hydronics2/nrf52840-PCC-January-2020/soldering/eagle_design_files/README.md

# Printed Circuit Board

This circuit board was designed in Eagle. Order the board on [Oshpark](https://oshpark.com/shared_projects/VXKHXb9R).

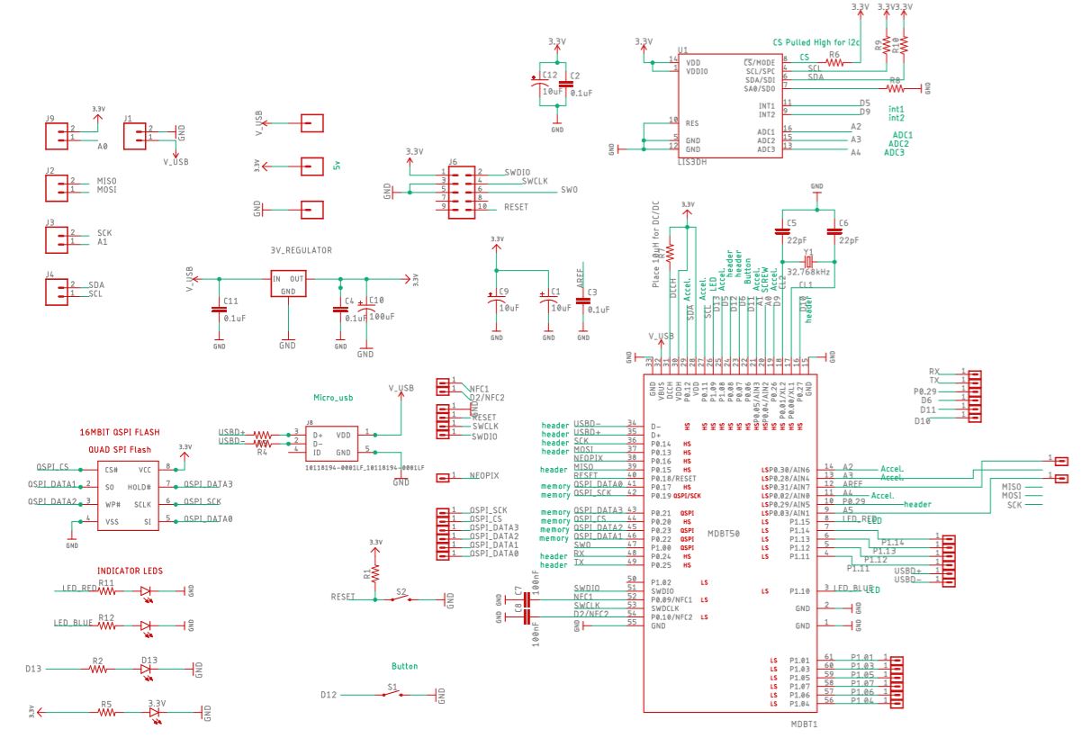
[picture p15: soldering/pics/schematic1.JPG]


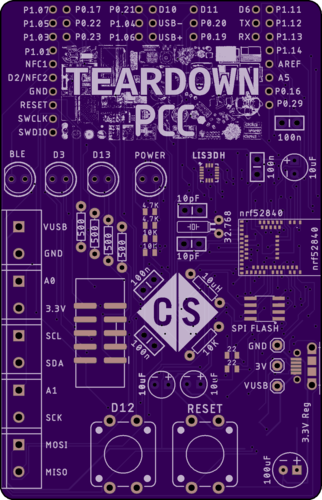
[picture p16: soldering/eagle_design_files/blank_top.png]


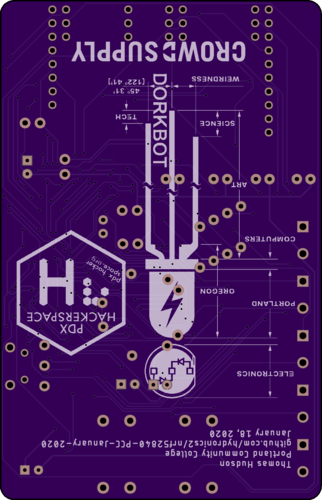
[picture p17: soldering/eagle_design_files/blank_bottom.png]
