hydronics2/nrf52840-PCC-January-2020/handout.pdf

## Teardown 2019 - Soldering and Web BLE tutorial

This is a soldering and programming class in Circuitpython that includes a Web Ble demo

github.com/hydronics2/Teardown-2019

This class occurs in two parts -- Soldering and Programming.

We'll be soldering parts and headers onto a custom printed circuit board(PCB).
This board is a copy of the Adafruit Feather nrf52840 express.

When you connect from USB to your computer it shows up as an external hard drive with pre-loaded example scripts.

Soldering Tutorial

Programming Tutorial

## Soldering

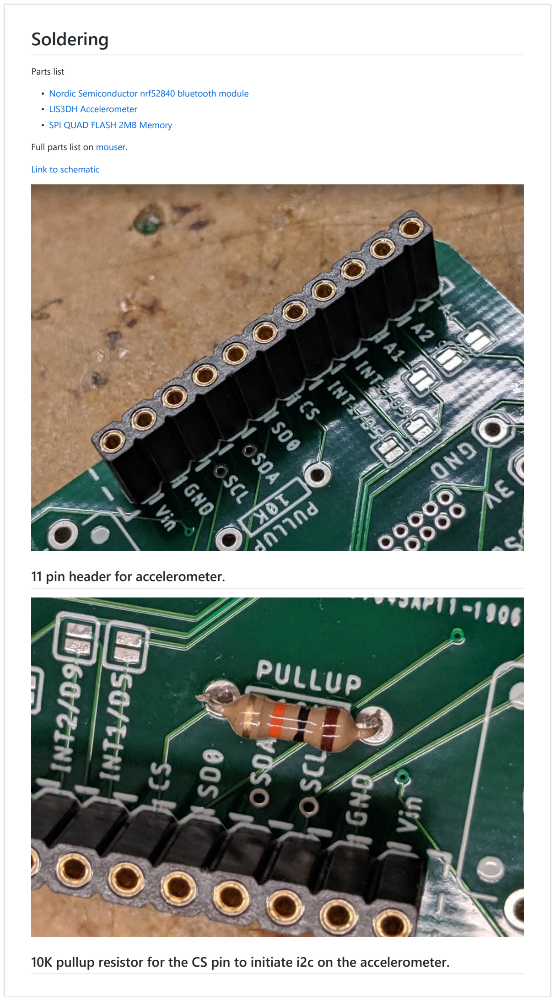
[picture p19: page 2]

Parts list

- Nordic Semiconductor nrf52840 bluetooth module
- LIS3DH Accelerometer
- SPI QUAD FLASH 2MB Memory

Full parts list on mouser.

Link to schematic

11 pin header for accelerometer.

10K pullup resistor for the CS pin to initiate i2c on the accelerometer.

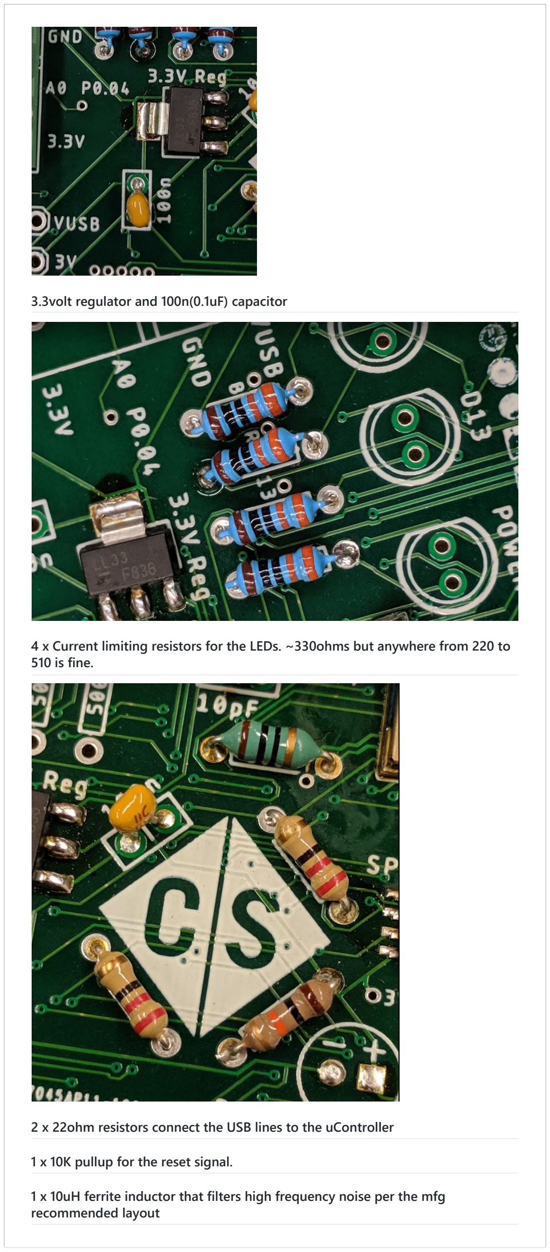
[picture p20: figure]
3.3volt regulator and 100n(0.1uF) capacitor; 510 is fine.; 1 x 10K pullup for the reset signal.; recommended layout

### 4 x Current limiting resistors for the LEDs. ~330ohms but anywhere from 220 to

### 2 x 22ohm resistors connect the USB lines to the uController

### 1 x 10uH ferrite inductor that filters high frequency noise per the mfg

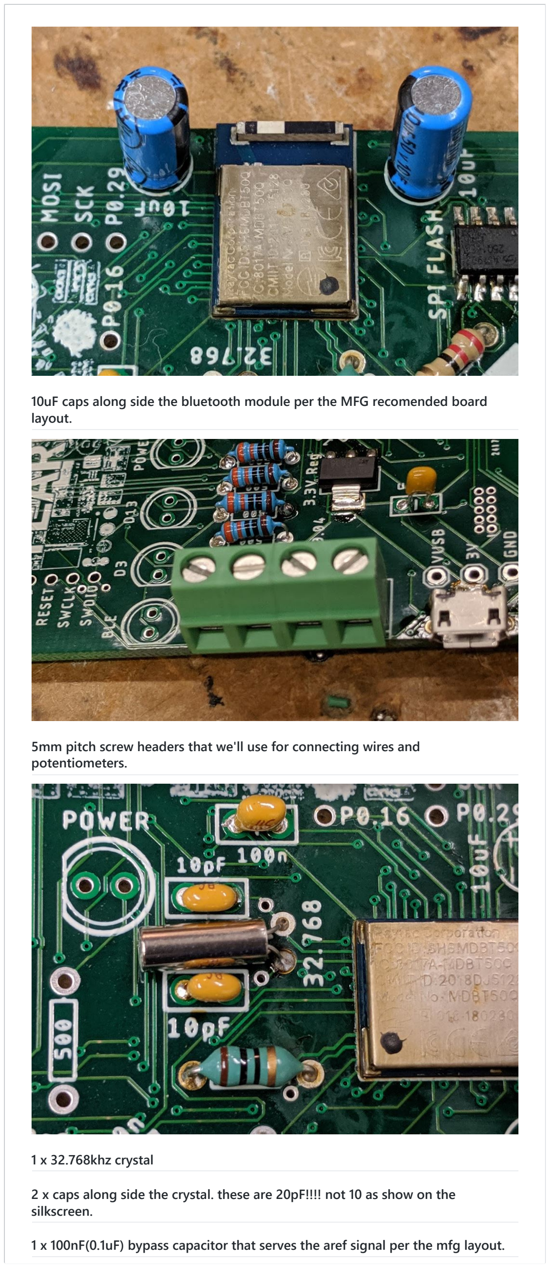
[picture p21: figure]
layout.; potentiometers.; 1 x 32.768khz crystal; silkscreen.

10uF caps along side the bluetooth module per the MFG recomended board

5mm pitch screw headers that we'll use for connecting wires and

### 2 x caps along side the crystal. these are 20pF!!!! not 10 as show on the

1 x 100nF(0.1uF) bypass capacitor that serves the aref signal per the mfg layout.

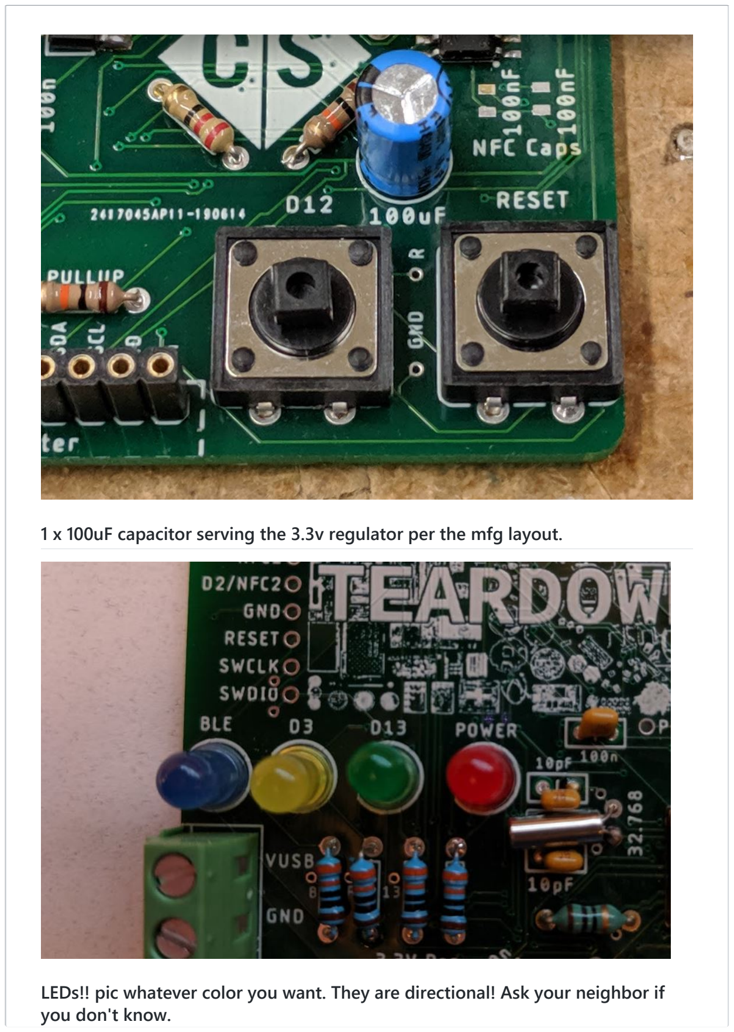
[picture p22: page 5]

1 x 100uF capacitor serving the 3.3v regulator per the mfg layout.

## LEDs!! pic whatever color you want. They are directional! Ask your neighbor if

you don't know.

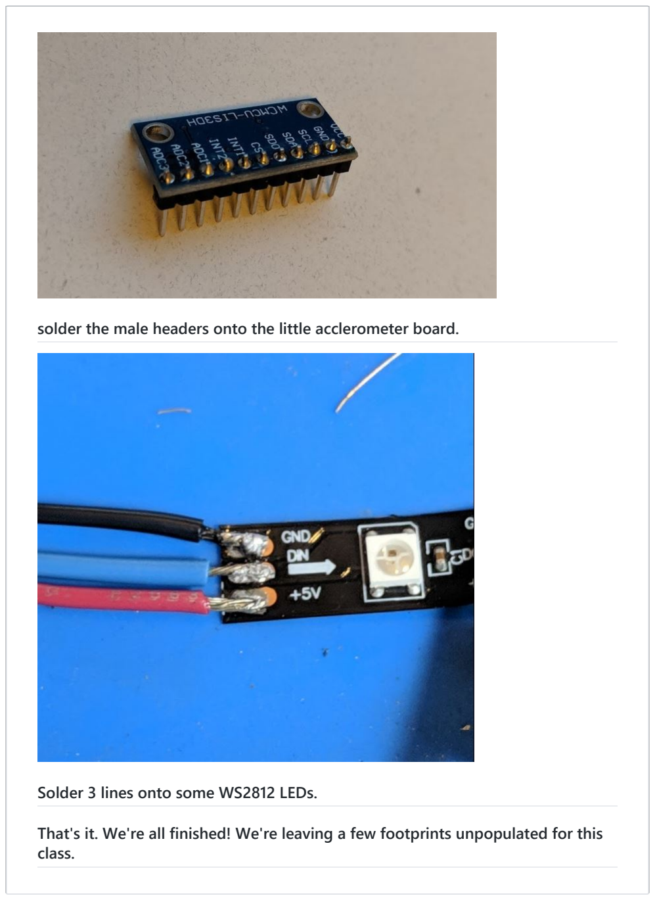
[picture p23: page 6]

solder the male headers onto the little acclerometer board.

Solder 3 lines onto some WS2812 LEDs.

## That's it. We're all finished! We're leaving a few footprints unpopulated for this

class.

# CircuitPython

If you need to flash a bare board... here are some steps..

I uploaded the python scripts onto the 2MB SPI Flash chip before the class. When you plug the unit into your board it appears as a flash drive.

Download and install the MU editor if you have not done so already.

## code.py

LOAD the code.py script. Code.py determines which scripts run. Uncomment the files you would like to run.

## blink

LOAD the "blink.py" script that's currently running. It blinks the LEDs on pin 13, pin 3, and BLUE_LED pin. Try adjusting the time.sleep(x) to speed up the blinking.

## Web Ble

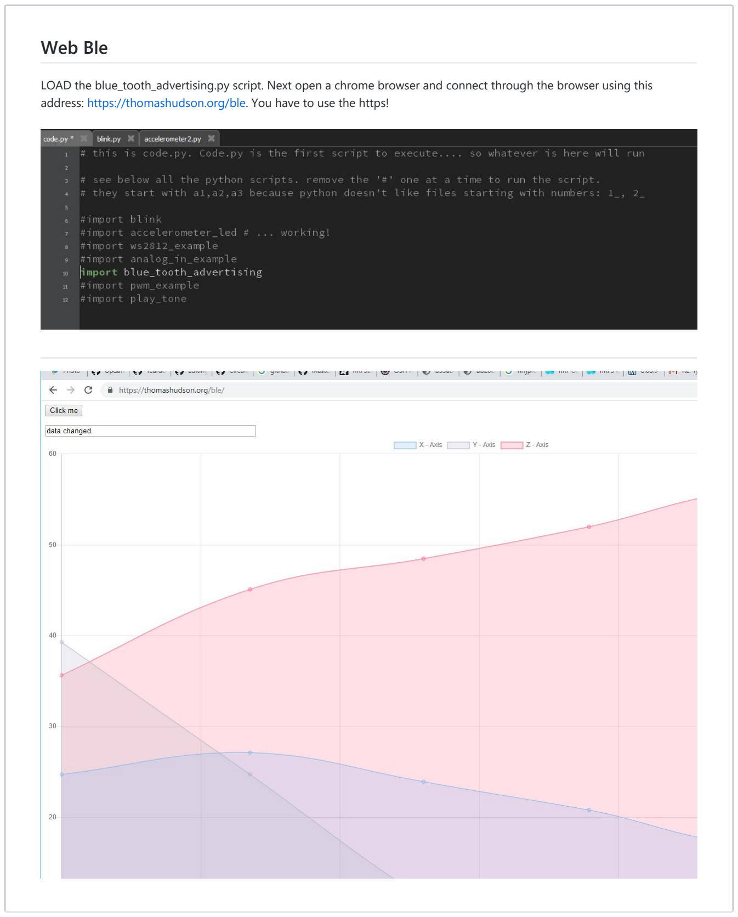
[picture p24: page 8]

LOAD the blue_tooth_advertising.py script. Next open a chrome browser and connect through the browser using this address: https://thomashudson.org/ble. You have to use the https!

## accelerometer

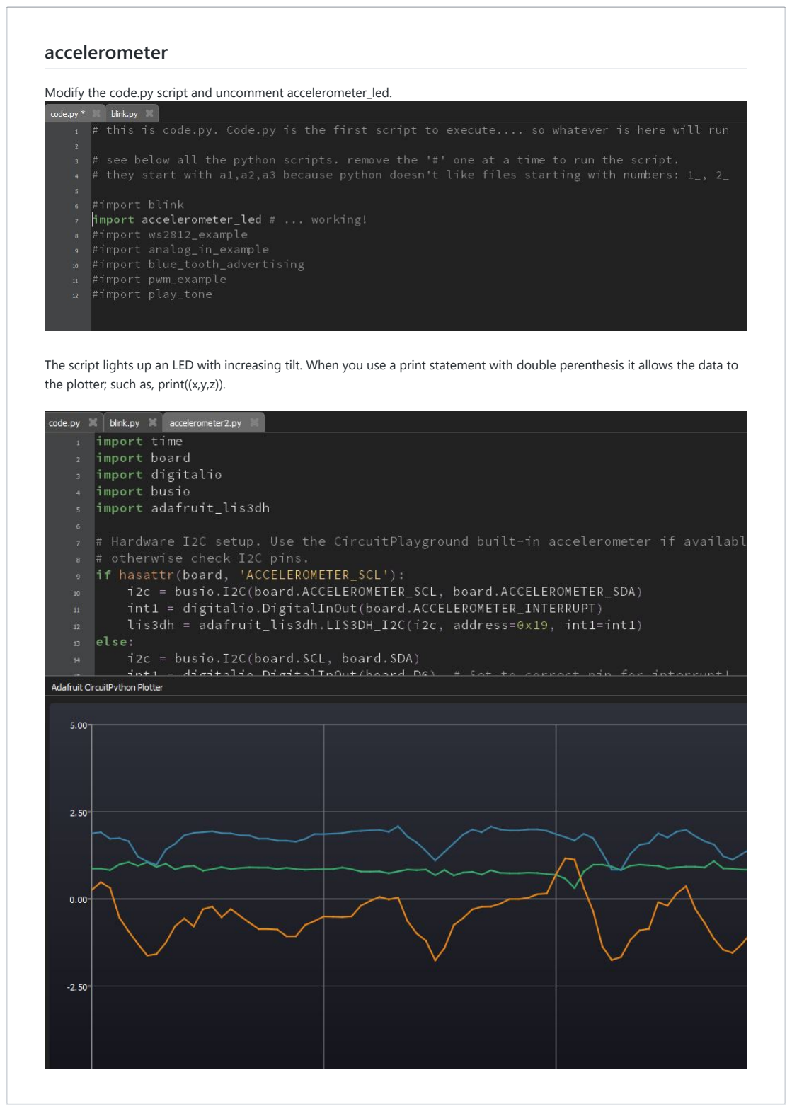
[picture p25: page 9]

Modify the code.py script and uncomment accelerometer_led.

The script lights up an LED with increasing tilt. When you use a print statement with double perenthesis it allows the data to the plotter; such as, print((x,y,z)).

## ws2812_example

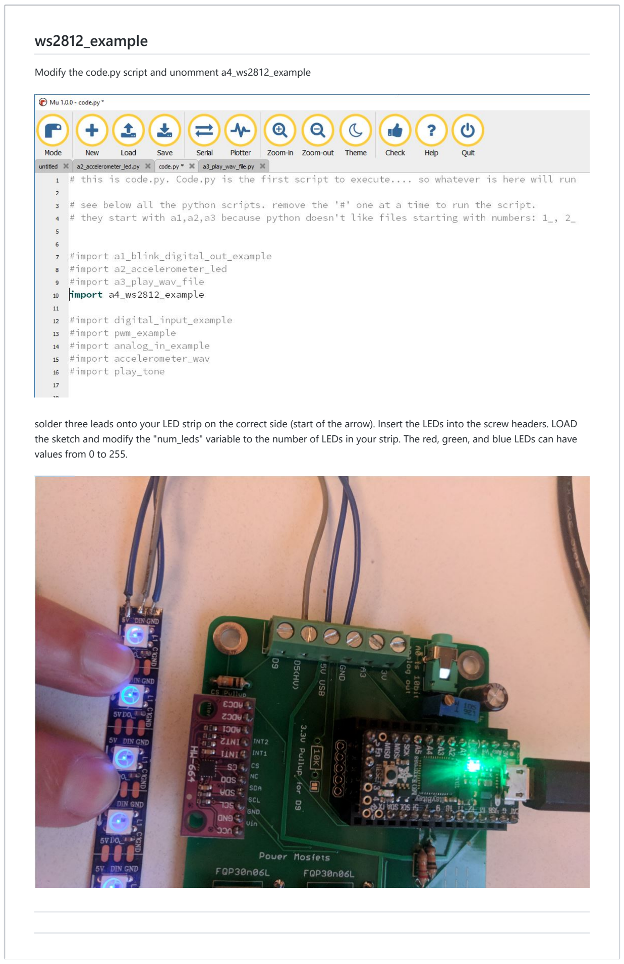
[picture p26: page 10]

Modify the code.py script and unomment a4_ws2812_example

solder three leads onto your LED strip on the correct side (start of the arrow). Insert the LEDs into the screw headers. LOAD the sketch and modify the "num_leds" variable to the number of LEDs in your strip. The red, green, and blue LEDs can have values from 0 to 255.

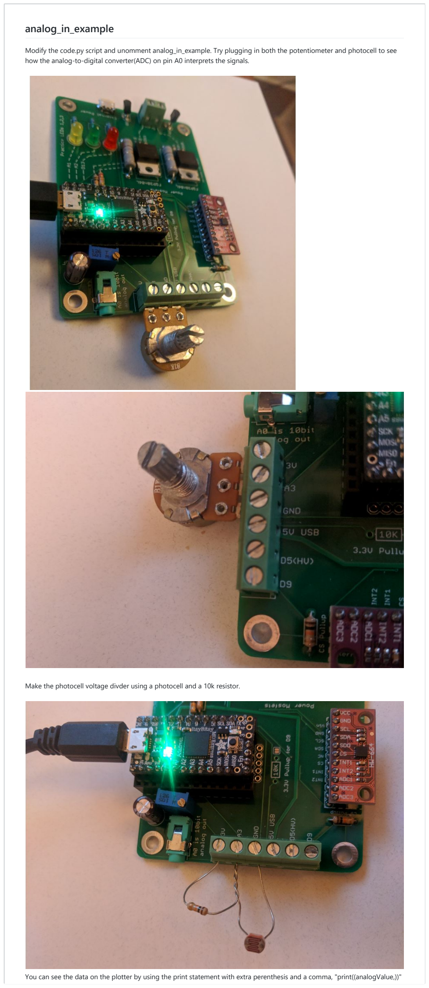
[picture p27: page 11]

analog_in_example

Modify the code.py script and unomment analog_in_example. Try plugging in both the potentiometer and photocell to see how the analog-to-digital converter(ADC) on pin A0 interprets the signals.

Make the photocell voltage divder using a photocell and a 10k resistor.

You can see the data on the plotter by using the print statement with extra perenthesis and a comma, "print((analogValue,))"
