hydronics2/nrf52840-PCC-January-2020/soldering/eagle_design_files/blank_top.JPG

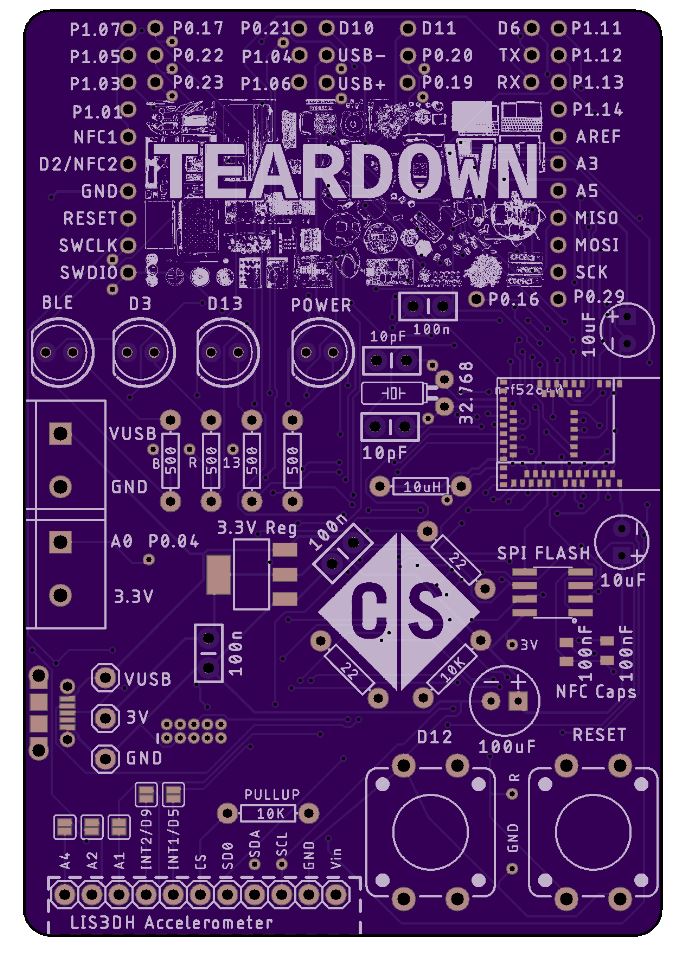
soldering/eagle_design_files/blank_top.JPG
