hydronics2/nrf52840-PCC-January-2020/soldering/README.md

# Soldering Instructions

## https://github.com/hydronics2/nrf52840-PCC-January-2020
Parts list
- [Nordic Semiconductor nrf52840 bluetooth module](https://www.adafruit.com/product/4078)
- [SPI QUAD FLASH 2MB Memory](https://www.digikey.com/product-detail/en/gigadevice-semiconductor-hk-limited/GD25Q16CTIGR/1970-1010-1-ND/9484760)

Full parts list on [mouser](https://www.mouser.com/ProjectManager/ProjectDetail.aspx?AccessID=5d5a690db9).

[Link to schematic](https://github.com/hydronics2/nrf52840-PCC-January-2020/blob/master/soldering/eagle_design_files/PCB_schematic1.pdf)

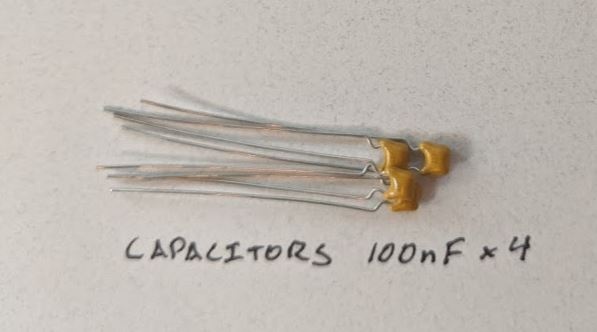
[picture p30: soldering/pics/1caps.jpg]

## qty(4) 100nF capacitors. not polarity specific.

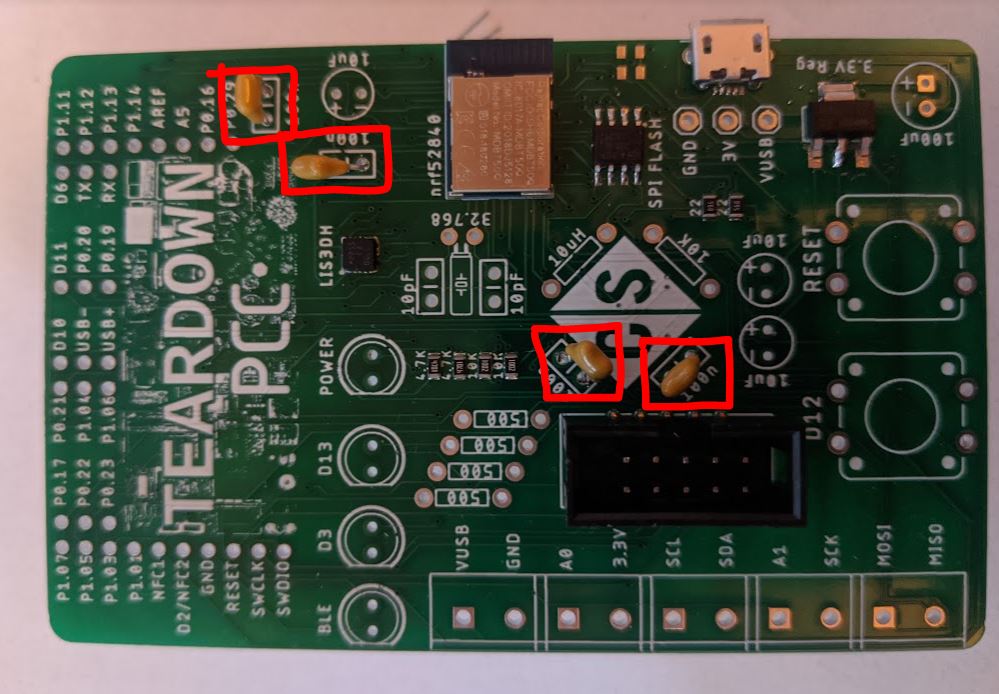
[picture p31: soldering/pics/2caps.JPG]


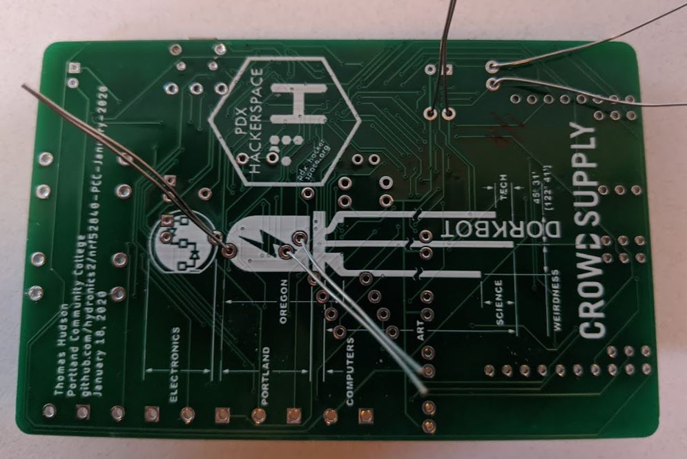
[picture p32: soldering/pics/3caps.JPG]


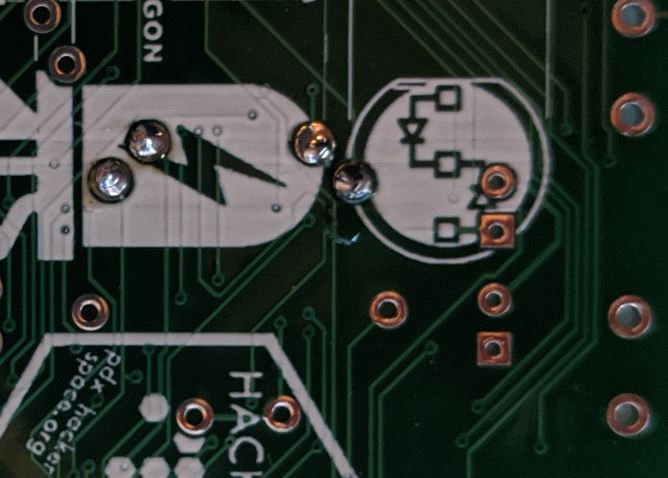
[picture p33: soldering/pics/4caps.JPG]

## push through the PCB, solder, and trim leads
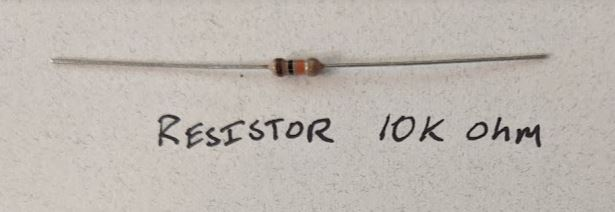
[picture p34: soldering/pics/5resistor.JPG]

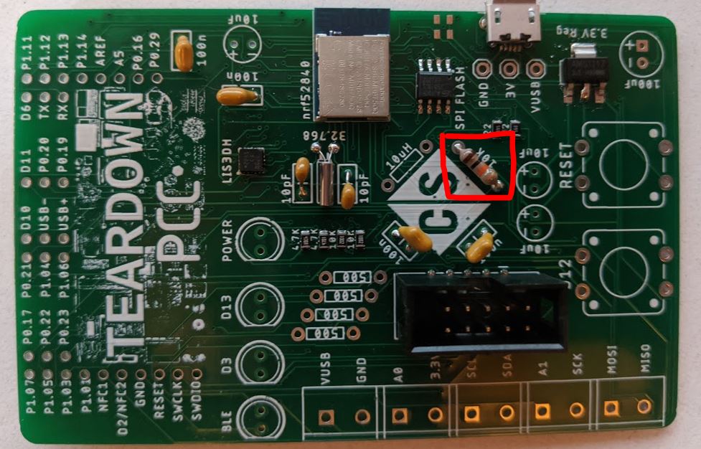
[picture p35: soldering/pics/6resistor.JPG]

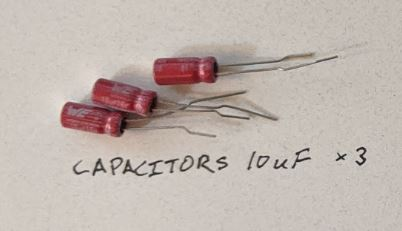
[picture p36: soldering/pics/7caps.JPG]

## qty(3) capacitors 10uF. POLARITY!!! match the stripe to the negative symbol (-)
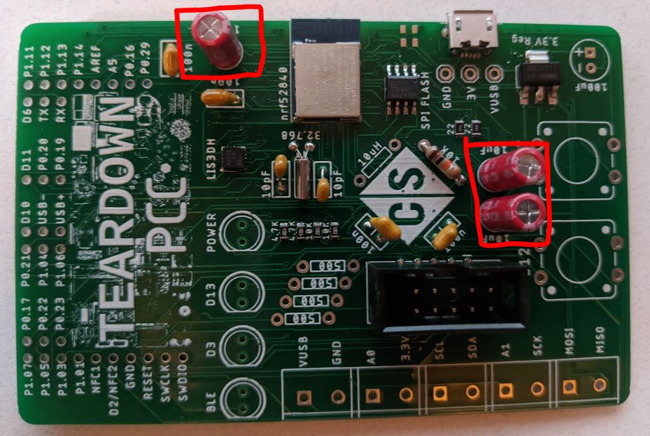
[picture p37: soldering/pics/8caps.JPG]

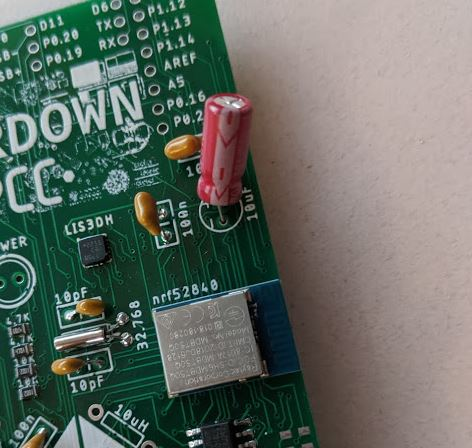
[picture p38: soldering/pics/9caps.JPG]

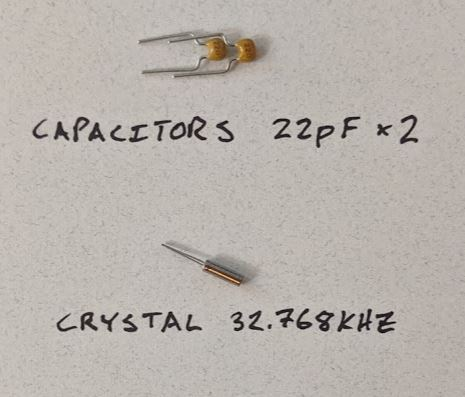
[picture p39: soldering/pics/10caps_crystal.JPG]

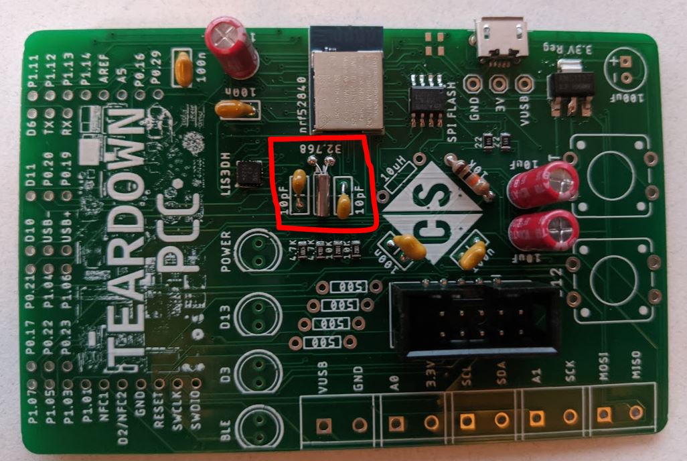
[picture p40: soldering/pics/11caps_crystal.JPG]

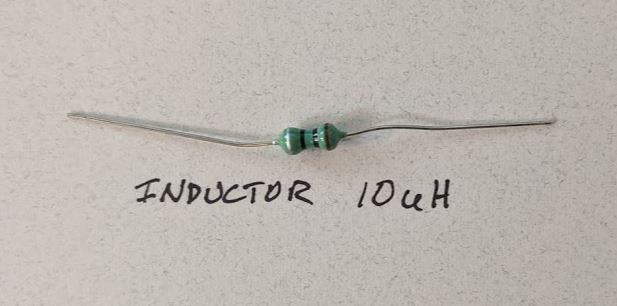
[picture p41: soldering/pics/12inductor.JPG]

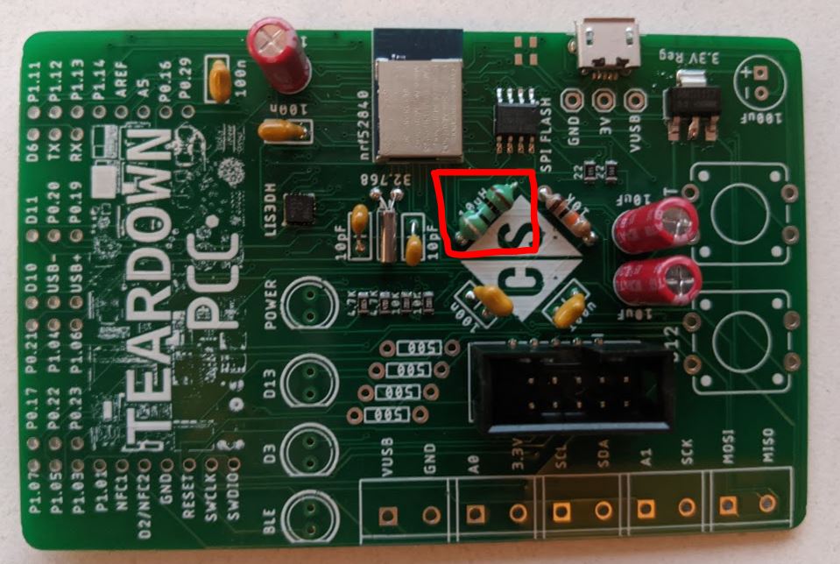
[picture p42: soldering/pics/13inductor.JPG]

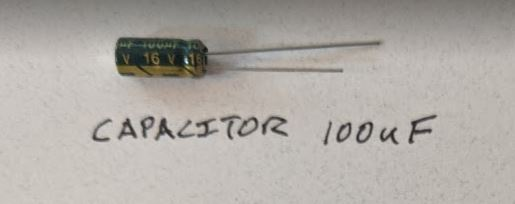
[picture p43: soldering/pics/14caps.JPG]

## qty(1) capacitors 100uF. POLARITY!!! match the stripe to the negative symbol (-)
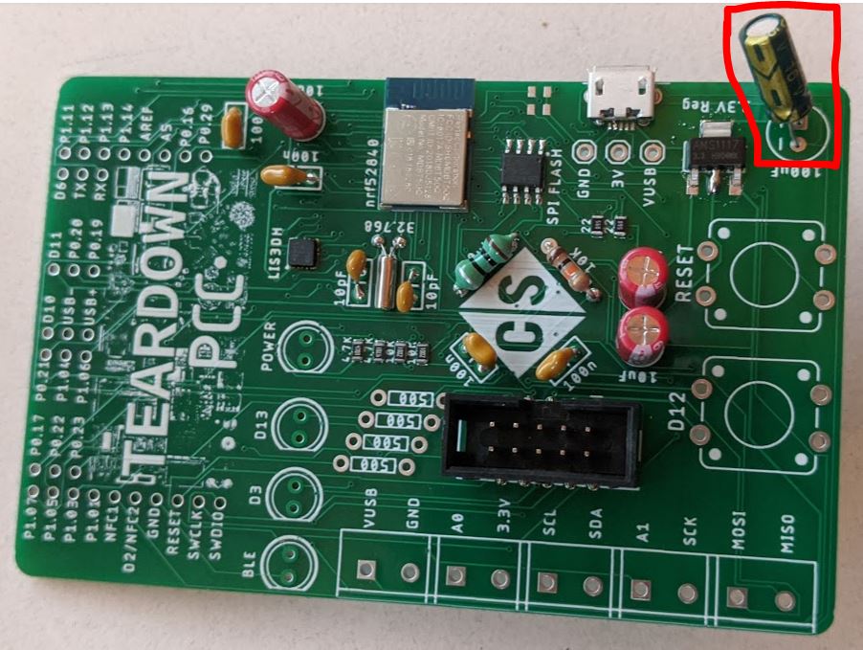
[picture p44: soldering/pics/15caps.JPG]

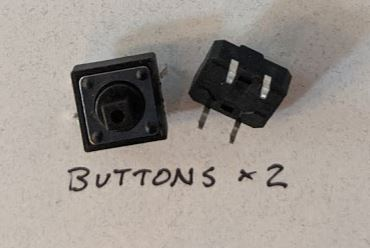
[picture p45: soldering/pics/16buttons.JPG]

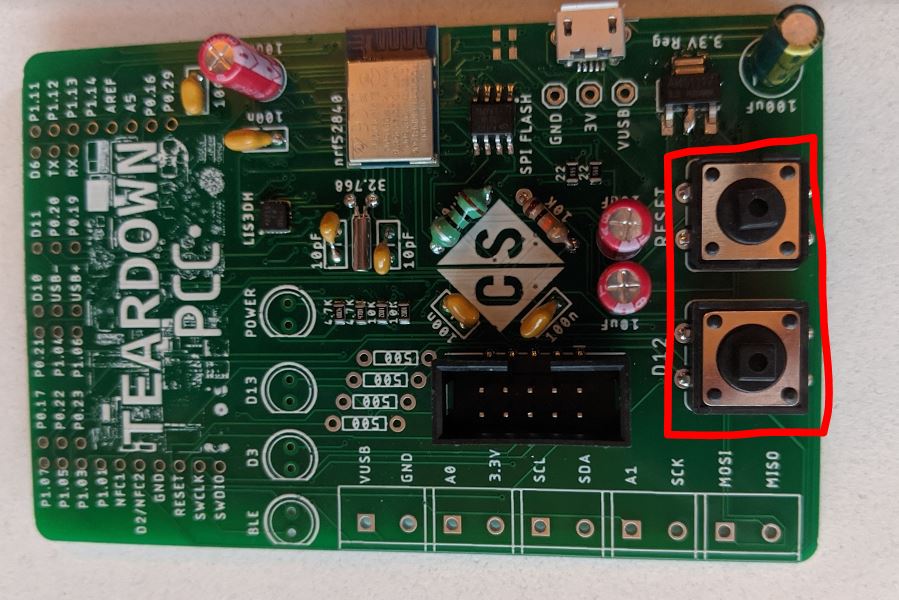
[picture p46: soldering/pics/17buttons.JPG]

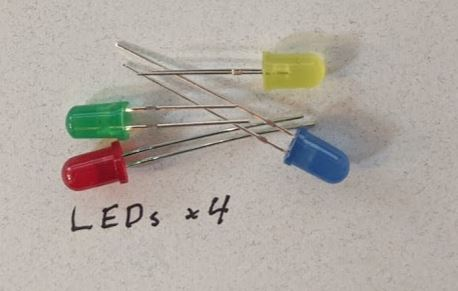
[picture p47: soldering/pics/18leds.JPG]

## qty(4) LEDs... any color. POLARITY!!! match the short leg to the flat side on the silkscreen
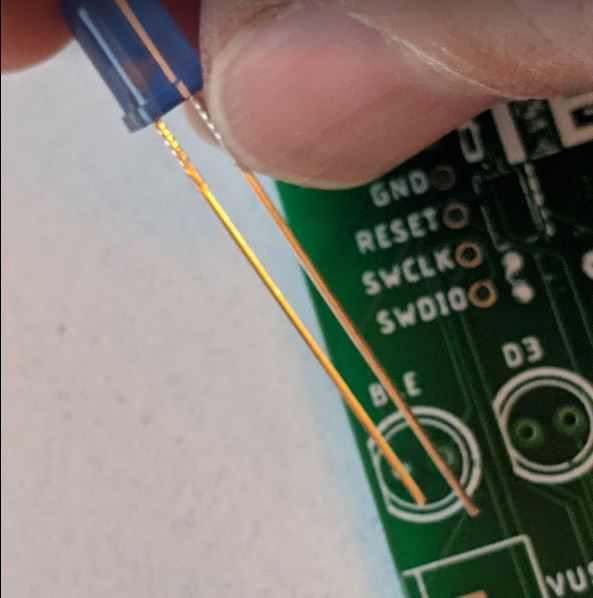
[picture p48: soldering/pics/19leds.JPG]

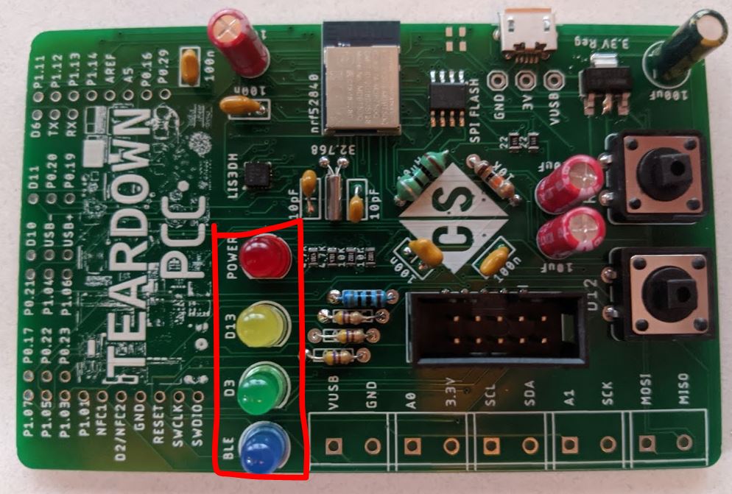
[picture p49: soldering/pics/20leds.JPG]

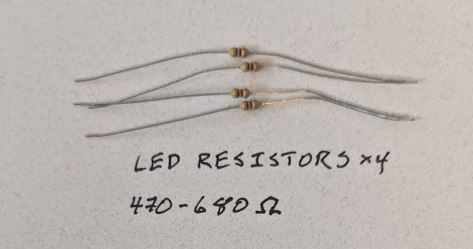
[picture p50: soldering/pics/21led_resistors.JPG]

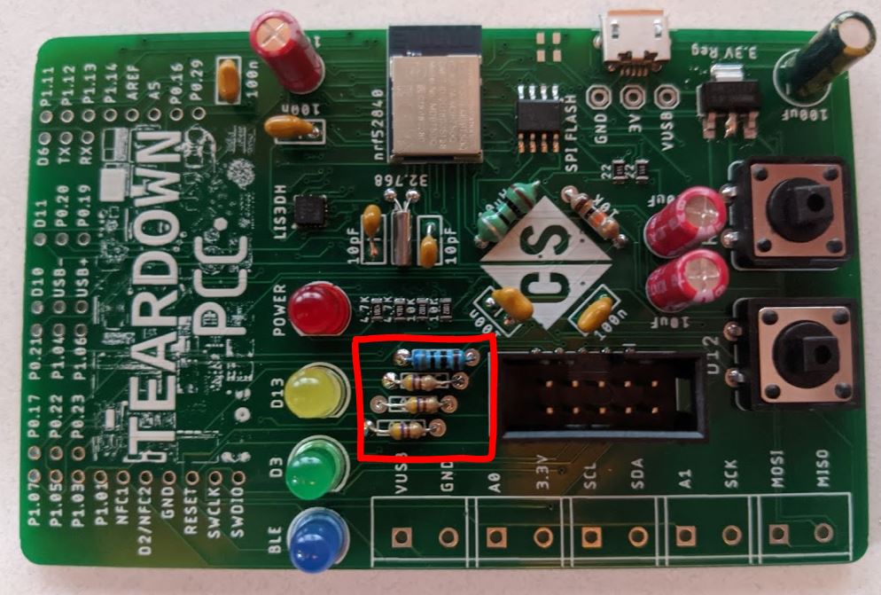
[picture p51: soldering/pics/22led_resistors.JPG]

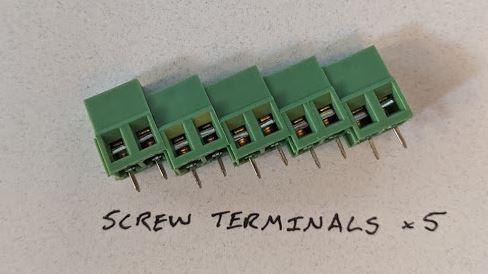
[picture p52: soldering/pics/23_screw_terminals.JPG]

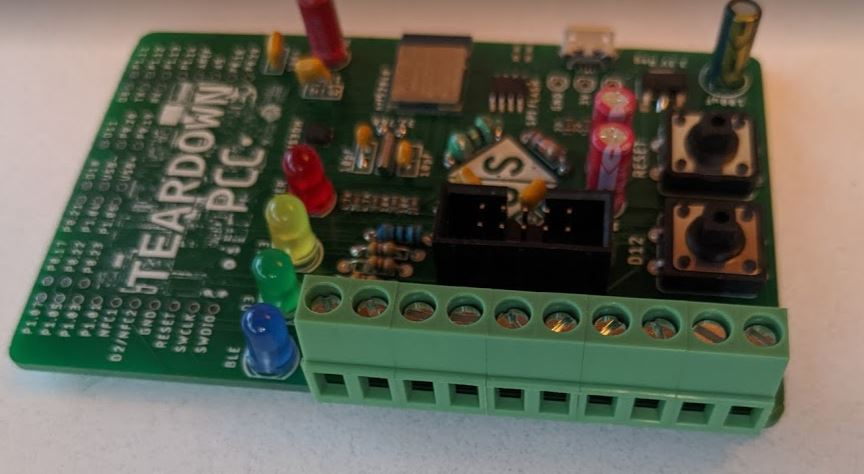
[picture p53: soldering/pics/24_screw_terminals.JPG]


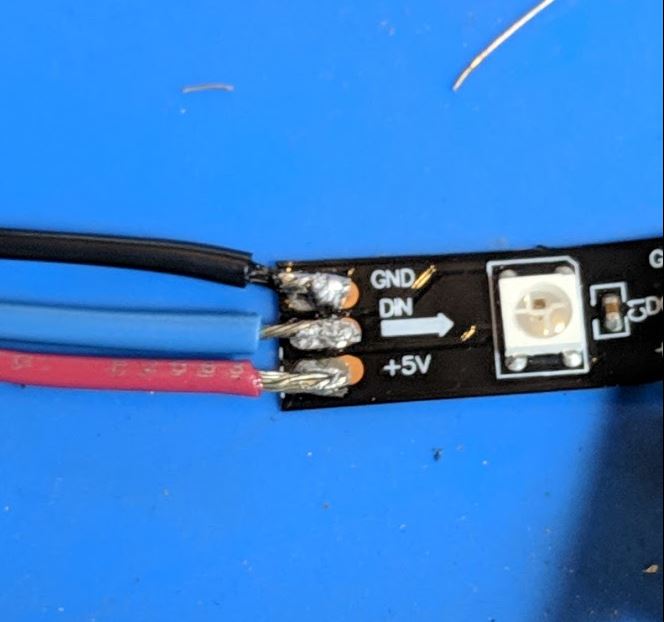
[picture p54: soldering/pics/ws2812.JPG]


## Solder 3 lines onto some WS2812 LEDs.

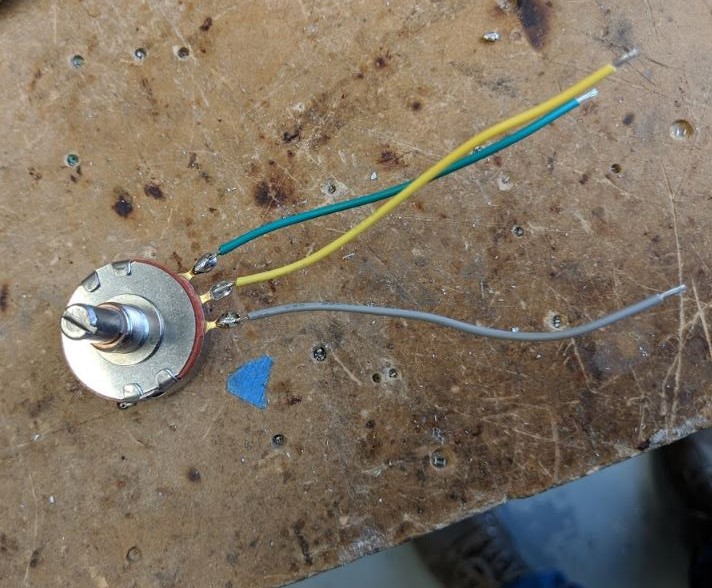
[picture p55: soldering/pics/22.jpg]


## Solder 3 wires onto the potentiometer.
## That's it. We're all finished! We're leaving a few footprints unpopulated for this class.
