hydronics2/nrf52840-PCC-January-2020/soldering/instructions.pdf

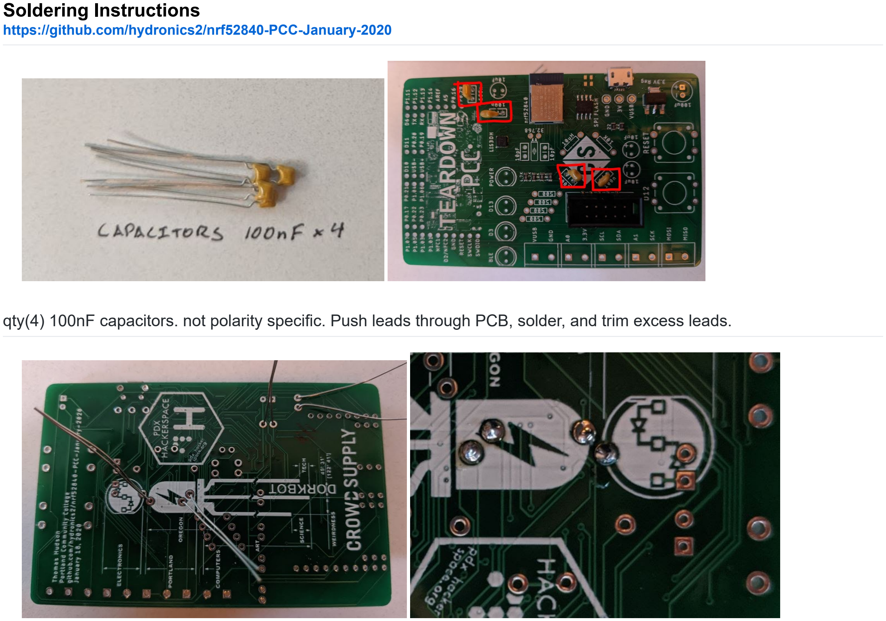
[picture p56: page 1]

Soldering Instructions
https://github.com/hydronics2/nrf52840-PCC-January-2020

qty(4) 100nF capacitors. not polarity specific. Push leads through PCB, solder, and trim excess leads.

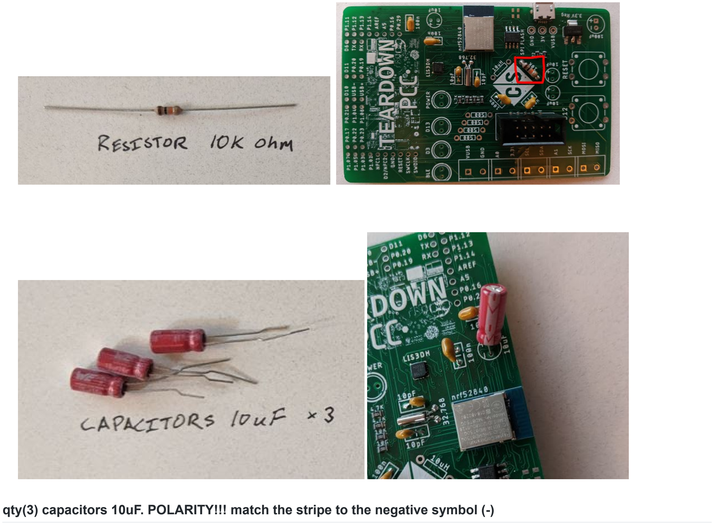
[picture p57: page 2]

qty(3) capacitors 10uF. POLARITY!!! match the stripe to the negative symbol (-)

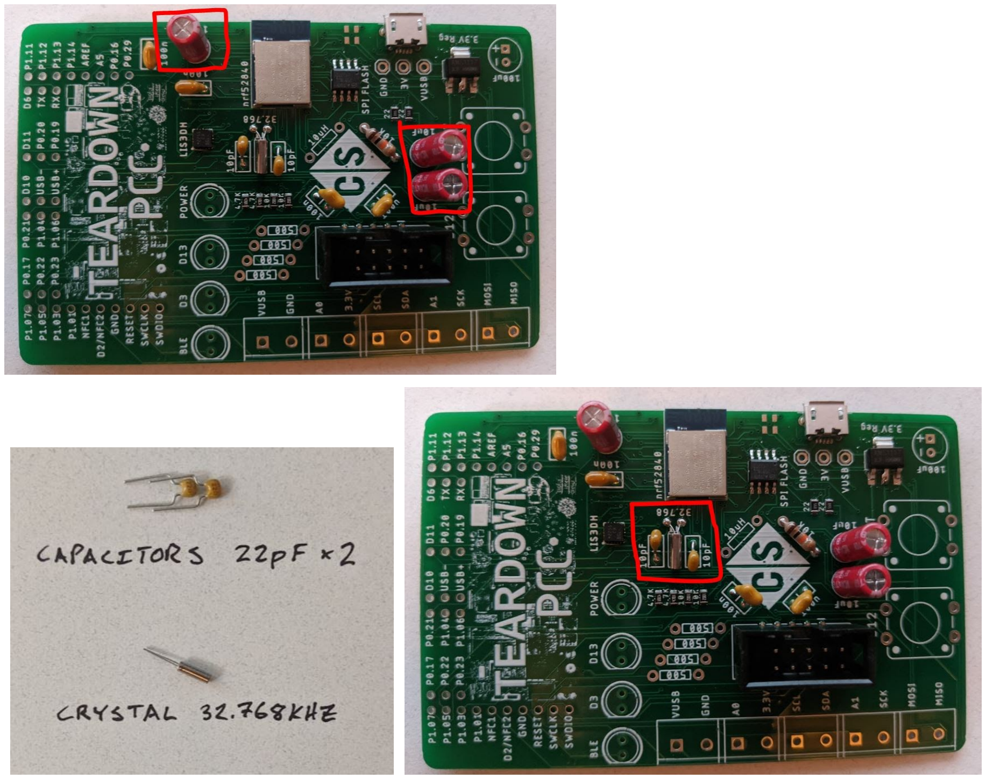
[picture p58: page 3]
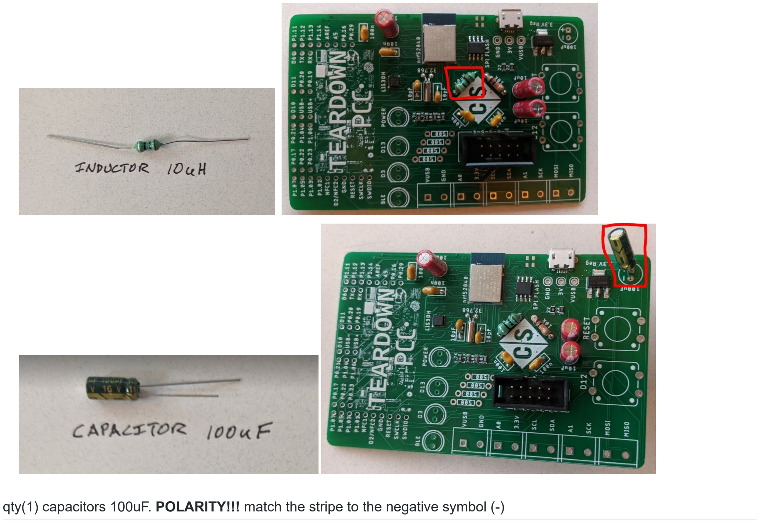
[picture p59: page 4]

qty(1) capacitors 100uF. POLARITY!!! match the stripe to the negative symbol (-)

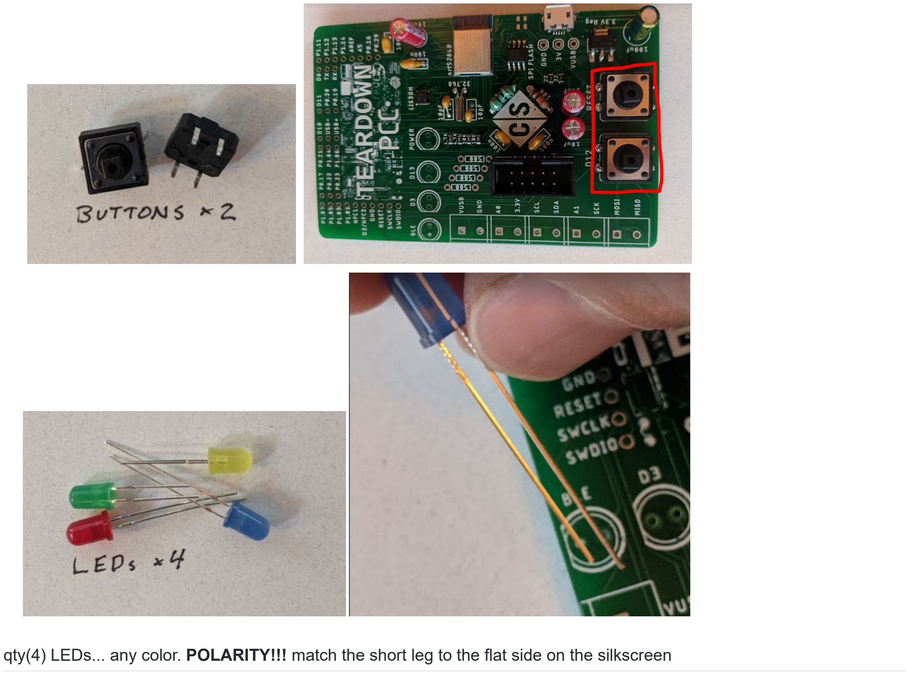
[picture p60: page 5]

qty(4) LEDs... any color. POLARITY!!! match the short leg to the flat side on the silkscreen

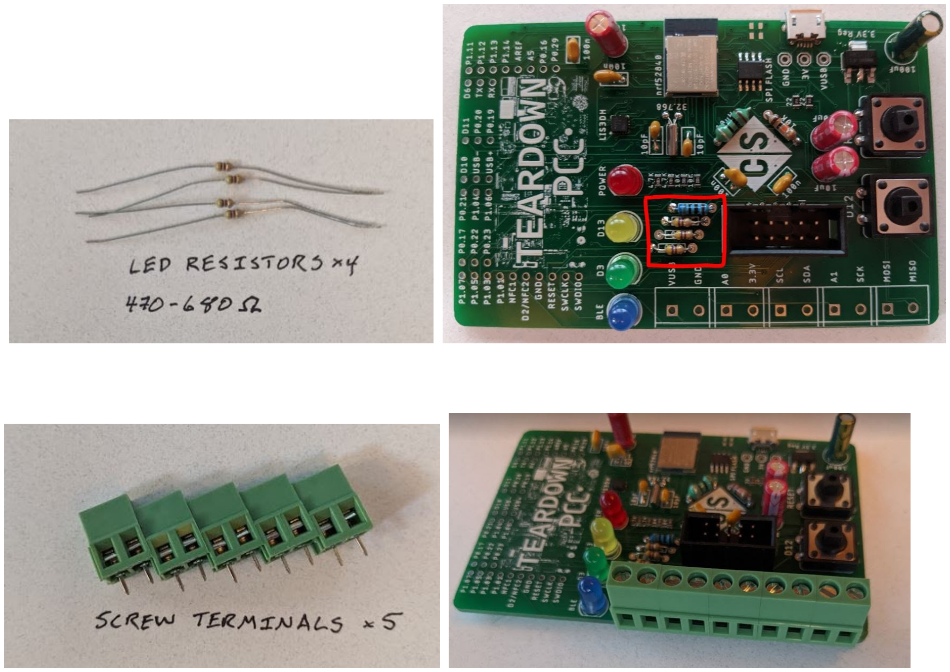
[picture p61: page 6]

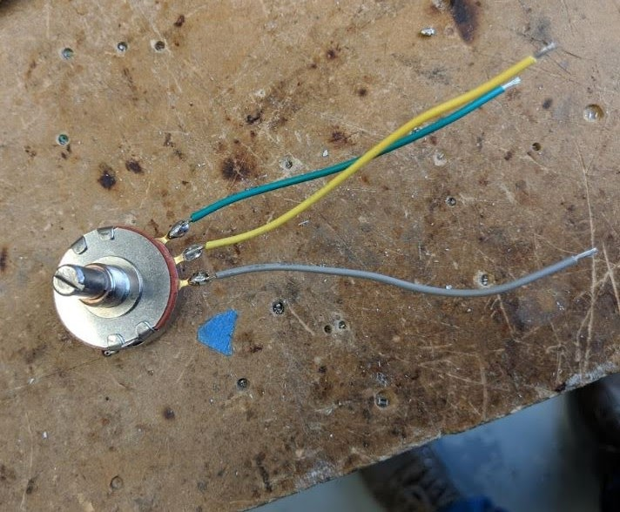
[picture p62: figure]
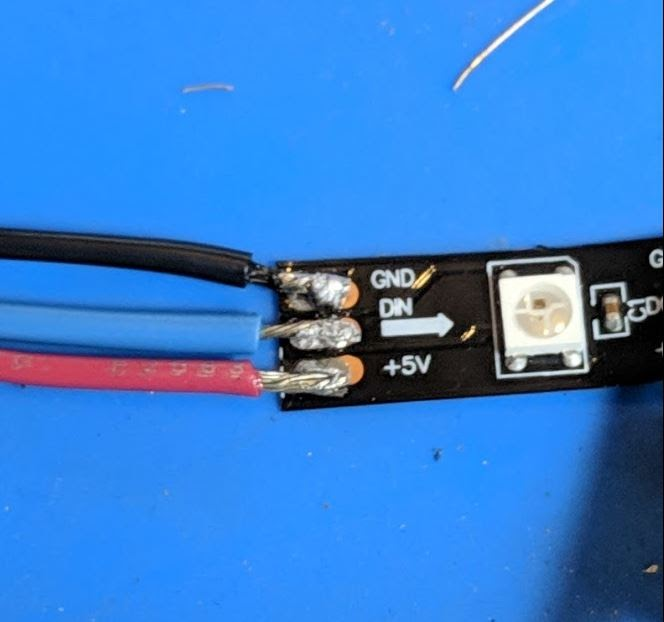
[picture p63: figure]

Solder 3 lines onto some WS2812 LEDs. | Solder 3 wires onto the potentiometer.
