hydronics2/nrf52840-PCC-January-2020/soldering/eagle_design_files/PCB_schematic1.pdf

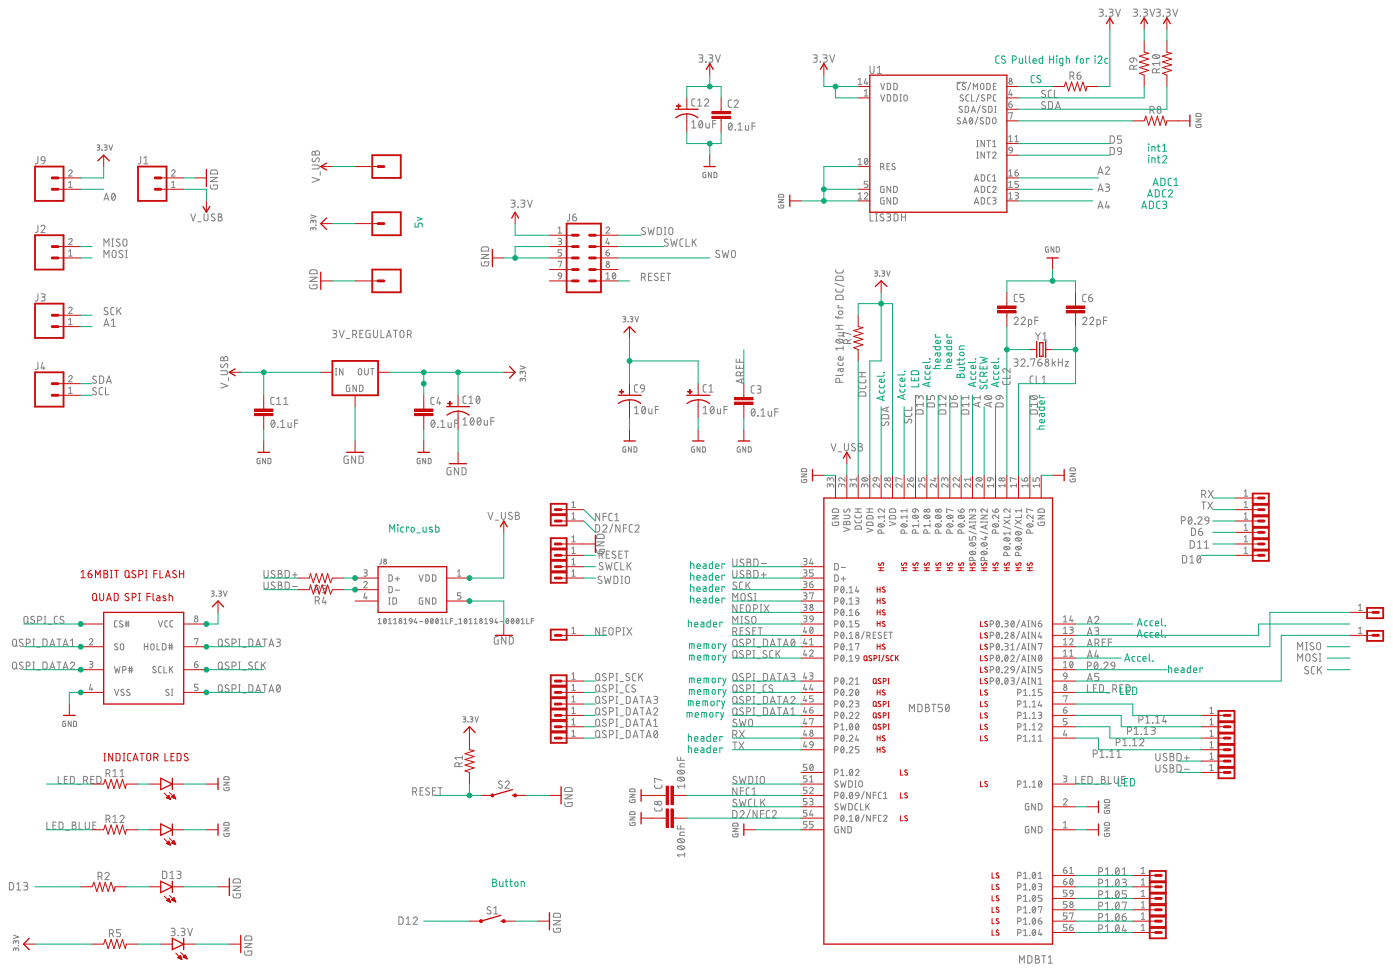
[picture p64: page 1]
