hydronics2/nrf52840-PCC-January-2020/soldering/eagle_design_files/class_nrf52840v2_module.sch

## EAGLE design soldering/eagle_design_files/class_nrf52840v2_module.sch (2020-01-16)

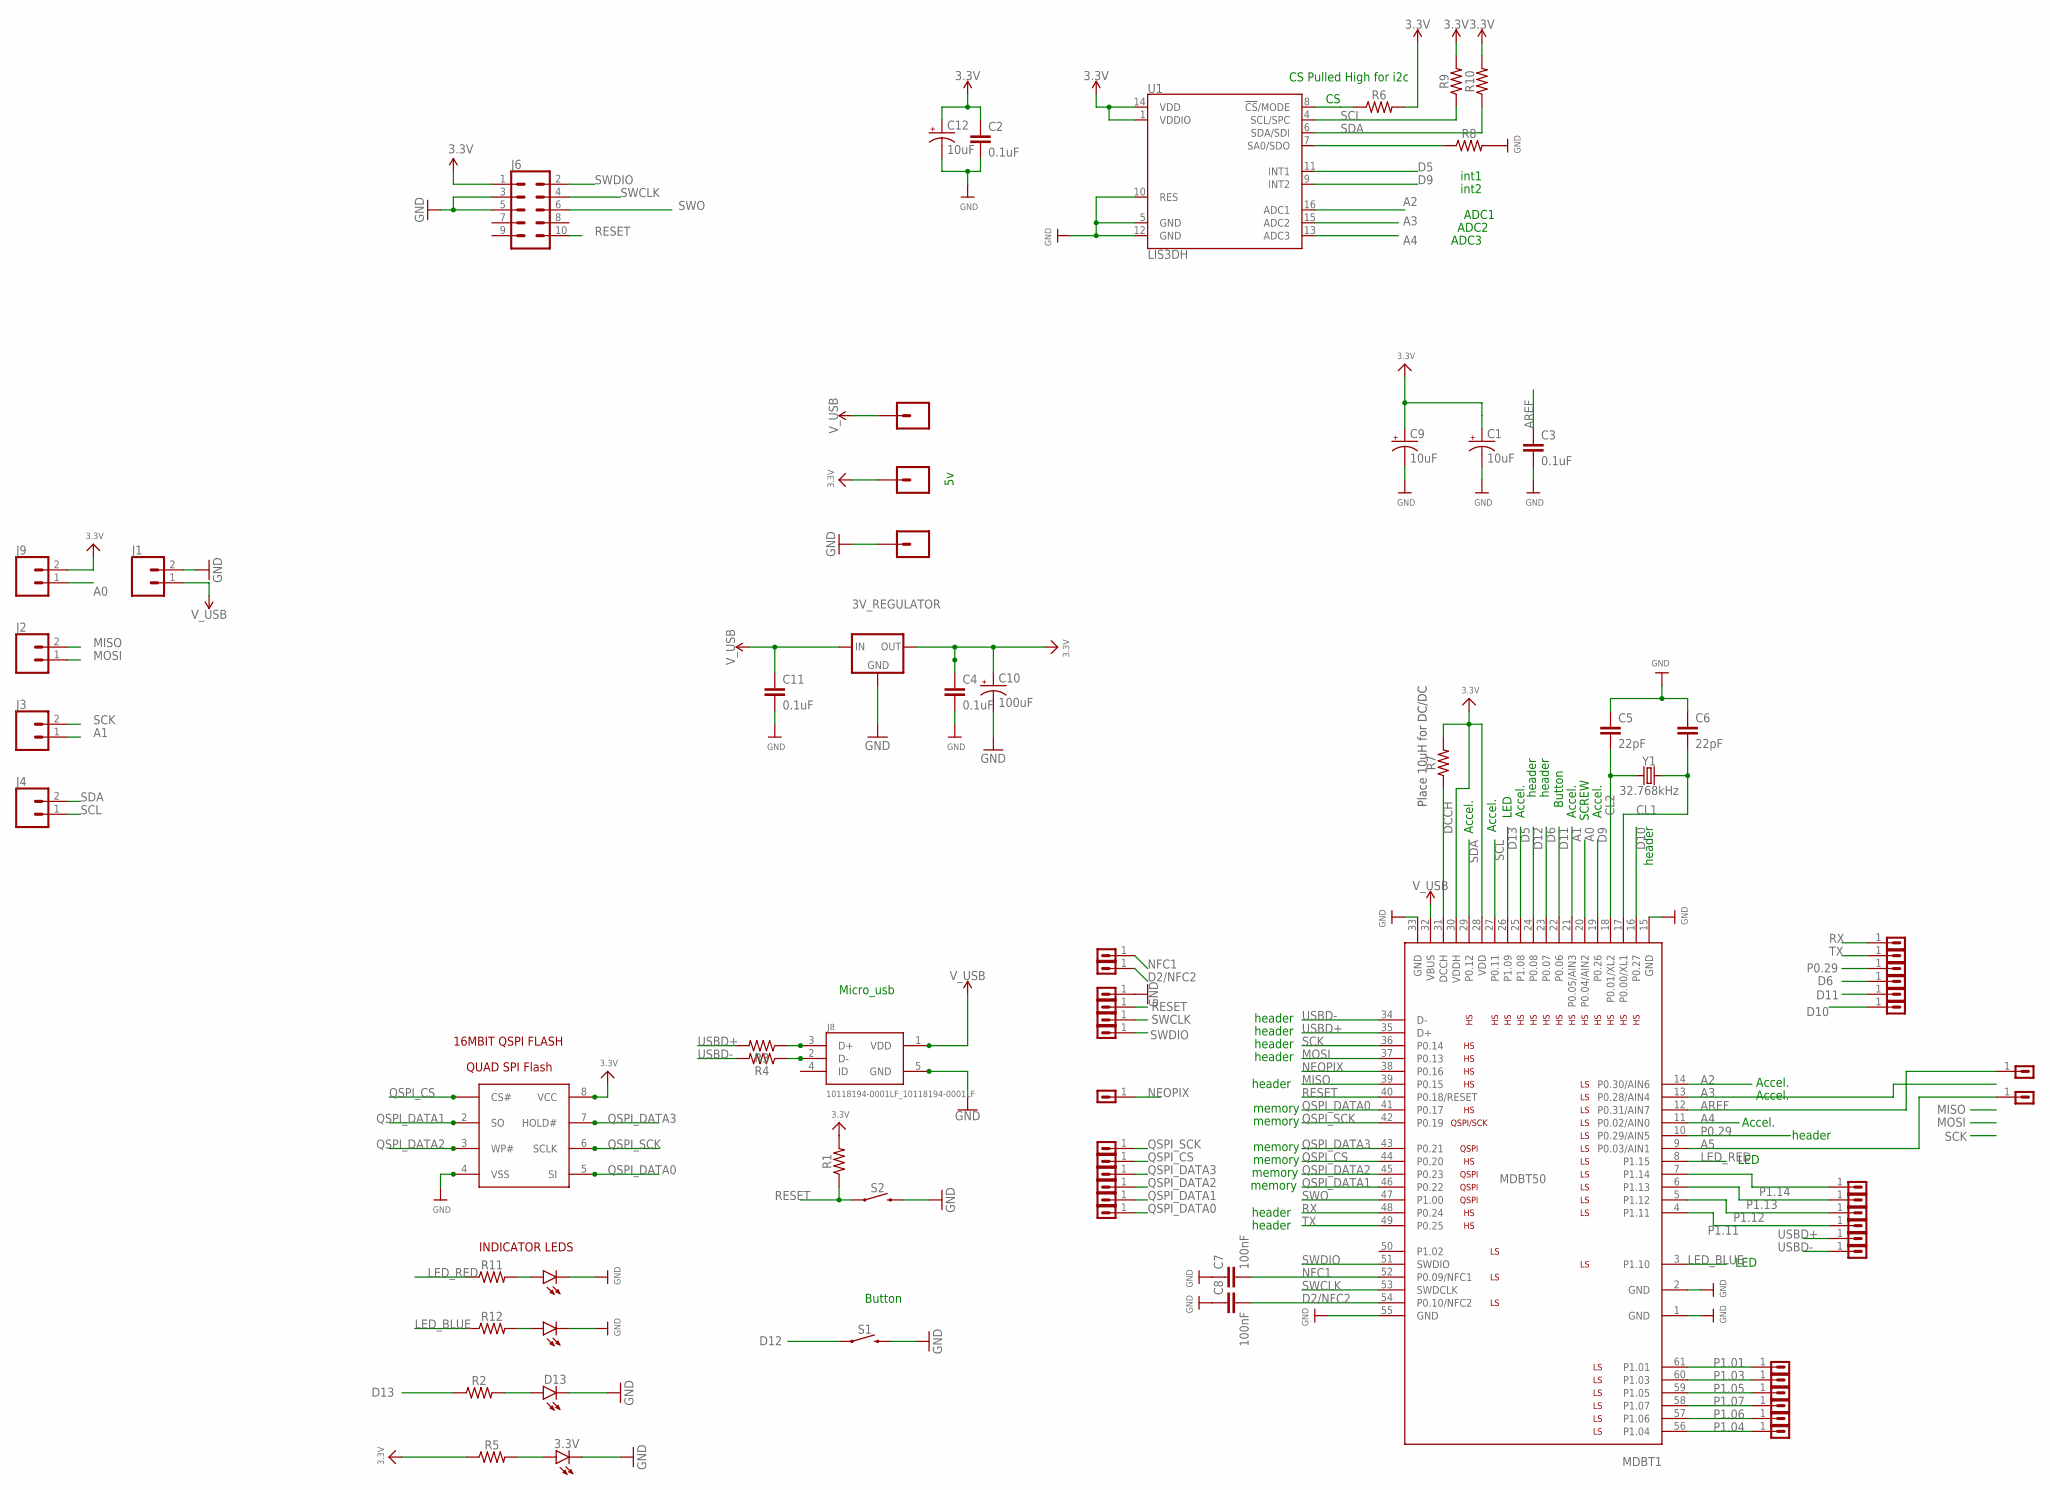
[picture p65: schematic class_nrf52840v2_module.sch]

Parts:
3.3V: LED5MM-KIT
3V_REGULATOR: LDL1117_5V_REG; SOT223
C1, C9, C12: 10uF; CPOL-RADIAL-2.5MM-5MM-KIT
C2, C3, C4, C11: 0.1uF; CAP-PTH-SMALL-KIT
C5, C6: 22pF; CAP-PTH-SMALL-KIT
C7, C8: 100nF; 0805
C10: 100uF; CPOL-RADIAL-2.5MM-6.5MM
D2, D3, D13: LED5MM-KIT
J1, J2, J3, J4, J9: CONN_025MM; SCREWTERMINAL-5MM-2
J5, J7, J17: M01PTH; 1X01
J6: CONN_05X2SHD_SMD; 2X5-SHROUDED_SMD
J8: 10118194-0001LF_10118194-0001LF; 10118194-0001LF_FRAMATOME_10118194-0001LF
MDBT1: MDBT50
R1, R2, R5, R7, R11, R12: AXIAL-0.3
R3, R4, R6, R8, R9, R10: 0805
S1, S2: MOMENTARY-SWITCH-SPST-PTH-12MM; TACTILE_SWITCH_PTH_12MM
U1: LIS3DH; LGA-16-3X3
U$4, U$21, U$24, U$26, U$28, U$30, U$31, U$32, U$33, U$34, U$35, U$36, U$37, U$38, U$39, U$40, U$41, U$42, U$43, U$45, U$56, U$57, U$58, U$59, U$60, U$61, U$62, U$63, U$64, U$65, U$66, U$67, U$68: CONN_0138MILL; 1X01-40MILL
U$29: QUAD_SPI_FLASHSOIC8_300MIL; SOIC8
Y1: 32.768kHz; CRYSTAL-PTH-2X6-CYL

Connections:
3.3V: 3V_REGULATOR.2 (OUT), C1.1 (+), C2.1, C4.1, C9.1 (+), C10.1 (+), C12.1 (+), J6.1, J9.2, J17.1, MDBT1.28 (VDD), MDBT1.30 (VDDH), R1.P$2 (2), R5.P$1 (1), R6.2, R7.P$2 (2), R9.2, R10.2, U1.1 (VDDIO), U1.14 (VDD), U$29.8 (VCC)
A0: J9.1, MDBT1.20 (P0.04/AIN2)
A1: J3.1, MDBT1.21 (P0.05/AIN3)
A2: MDBT1.14 (P0.30/AIN6), U1.16 (ADC1)
A3: MDBT1.13 (P0.28/AIN4), U1.15 (ADC2)
A4: MDBT1.11 (P0.02/AIN0), U1.13 (ADC3)
A5: MDBT1.9 (P0.03/AIN1), U$45.1
AREF: C3.1, MDBT1.12 (P0.31/AIN7), U$43.1
CL1: C6.2, MDBT1.17 (P0.00/XL1), Y1.2
CL2: C5.2, MDBT1.18 (P0.01/XL2), Y1.1
D2/NFC2: C8.2, MDBT1.54 (P0.10/NFC2), U$21.1
D5: MDBT1.25 (P1.08), U1.11 (INT1)
D6: MDBT1.23 (P0.07), U$40.1
D9: MDBT1.19 (P0.26), U1.9 (INT2)
D10: MDBT1.16 (P0.27), U$42.1
D11: MDBT1.22 (P0.06), U$41.1
D12: MDBT1.24 (P0.08), S1.1
D13: MDBT1.26 (P1.09), R2.P$1 (1)
DCCH: MDBT1.31 (DCCH), R7.P$1 (1)
GND: 3.3V.K (C), 3V_REGULATOR.1 (GND), C1.2 (-), C2.2, C3.2, C4.2, C5.1, C6.1, C7.1, C8.1, C9.2 (-), C10.2 (-), C11.2, C12.2 (-), D2.K (C), D3.K (C), D13.K (C), J1.2, J6.3, J6.5, J7.1, J8.5 (GND), MDBT1.1 (GND), MDBT1.2 (GND), MDBT1.15 (GND), MDBT1.33 (GND), MDBT1.55 (GND), R8.2, S1.3 (2), S2.3 (2), U1.5 (GND), U1.10 (RES), U1.12 (GND), U$24.1, U$29.4 (VSS)
LED_BLUE: MDBT1.3 (P1.10), R12.P$1 (1)
LED_RED: MDBT1.8 (P1.15), R11.P$1 (1)
MISO: J2.2, MDBT1.39 (P0.15)
MOSI: J2.1, MDBT1.37 (P0.13)
unnamed: D3.A, R11.P$2 (2)
unnamed: J8.3 (D+), R3.1
unnamed: J8.2 (D-), R4.1
unnamed: R6.1, U1.8 (!CS!/MODE)
unnamed: R8.1, U1.7 (SA0/SDO)
unnamed: D2.A, R12.P$2 (2)
unnamed: 3.3V.A, R5.P$2 (2)
unnamed: D13.A, R2.P$2 (2)
NEOPIX: MDBT1.38 (P0.16), U$68.1
NFC1: C7.2, MDBT1.52 (P0.09/NFC1), U$4.1
P0.29: MDBT1.10 (P0.29/AIN5), U$39.1
P1.01: MDBT1.61 (P1.01), U$62.1
P1.03: MDBT1.60 (P1.03), U$63.1
P1.04: MDBT1.56 (P1.04), U$67.1
P1.05: MDBT1.59 (P1.05), U$64.1
P1.06: MDBT1.57 (P1.06), U$66.1
P1.07: MDBT1.58 (P1.07), U$65.1
P1.11: MDBT1.4 (P1.11), U$59.1
P1.12: MDBT1.5 (P1.12), U$58.1
P1.13: MDBT1.6 (P1.13), U$57.1
P1.14: MDBT1.7 (P1.14), U$56.1
QSPI_CS: MDBT1.44 (P0.20), U$29.1 (CS#), U$32.1
QSPI_DATA0: MDBT1.41 (P0.17), U$29.5 (SI), U$36.1
QSPI_DATA1: MDBT1.46 (P0.22), U$29.2 (SO), U$35.1
QSPI_DATA2: MDBT1.45 (P0.23), U$29.3 (WP#), U$34.1
QSPI_DATA3: MDBT1.43 (P0.21), U$29.7 (HOLD#), U$33.1
QSPI_SCK: MDBT1.42 (P0.19), U$29.6 (SCLK), U$31.1
RESET: J6.10, MDBT1.40 (P0.18/RESET), R1.P$1 (1), S2.1, U$26.1
RX: MDBT1.48 (P0.24), U$37.1
SCK: J3.2, MDBT1.36 (P0.14)
SCL: J4.1, MDBT1.27 (P0.11), R9.1, U1.4 (SCL/SPC)
SDA: J4.2, MDBT1.29 (P0.12), R10.1, U1.6 (SDA/SDI)
SWCLK: J6.4, MDBT1.53 (SWDCLK), U$28.1
SWDIO: J6.2, MDBT1.51 (SWDIO), U$30.1
SWO: J6.6, MDBT1.47 (P1.00)
TX: MDBT1.49 (P0.25), U$38.1
USBD+: MDBT1.35 (D+), R3.2, U$60.1
USBD-: MDBT1.34 (D-), R4.2, U$61.1
V_USB: 3V_REGULATOR.3 (IN), C11.1, J1.1, J5.1, J8.1 (VDD), MDBT1.32 (VBUS)

Notes on the sheet:
Micro_usb
Place 10uH for DC/DC
16MBIT QSPI FLASH
INDICATOR LEDS
int1
CS Pulled High for i2c
int2
LED
Accel.
ADC1
ADC2
ADC3
SCREW
memory
header
Button
